pruwait/Nice_BusT4/img/3hs.jpg

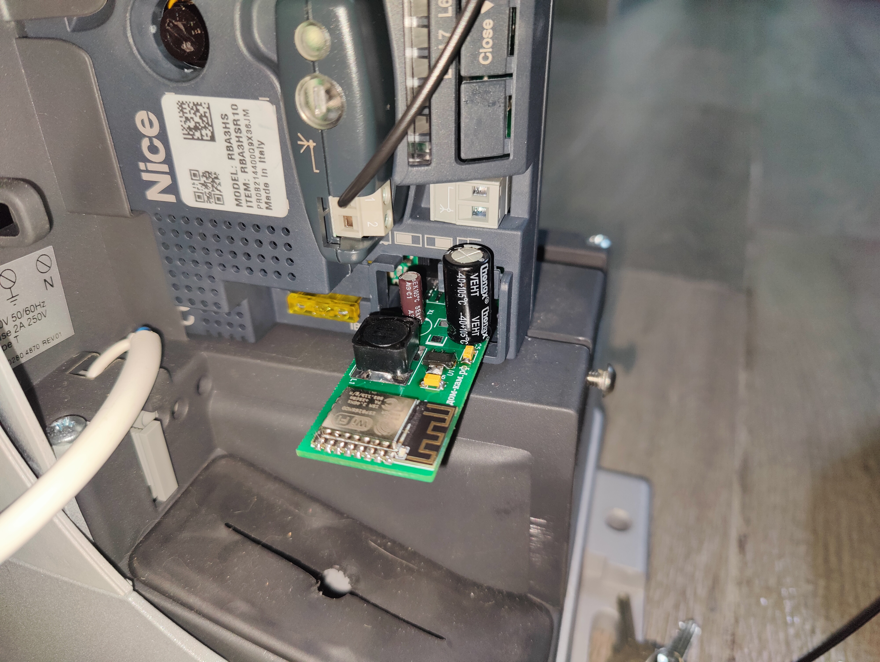
img/3hs.jpg
