pruwait/Nice_BusT4/img/924.jpg

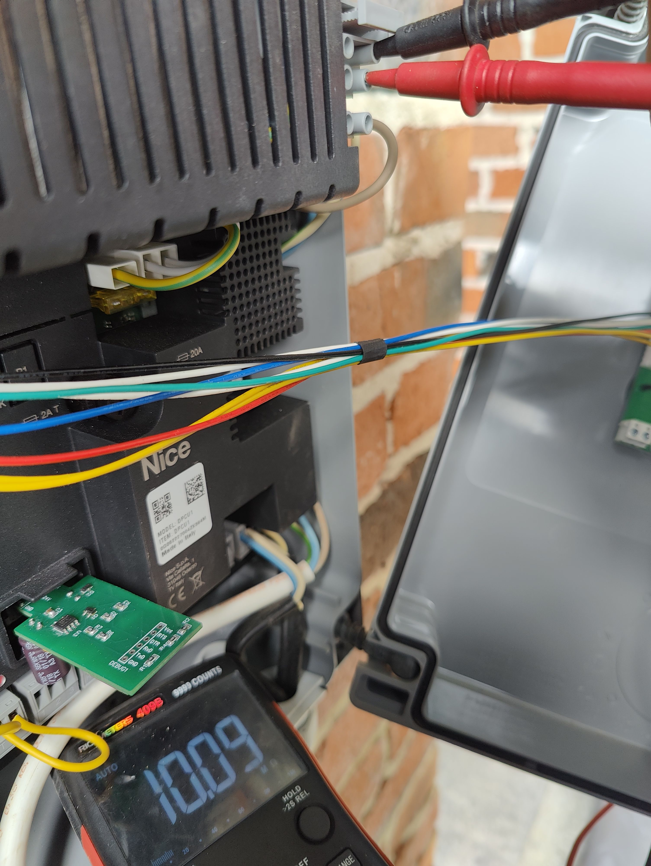
img/924.jpg
