pruwait/Nice_BusT4/img/IMG20240531091711.jpg

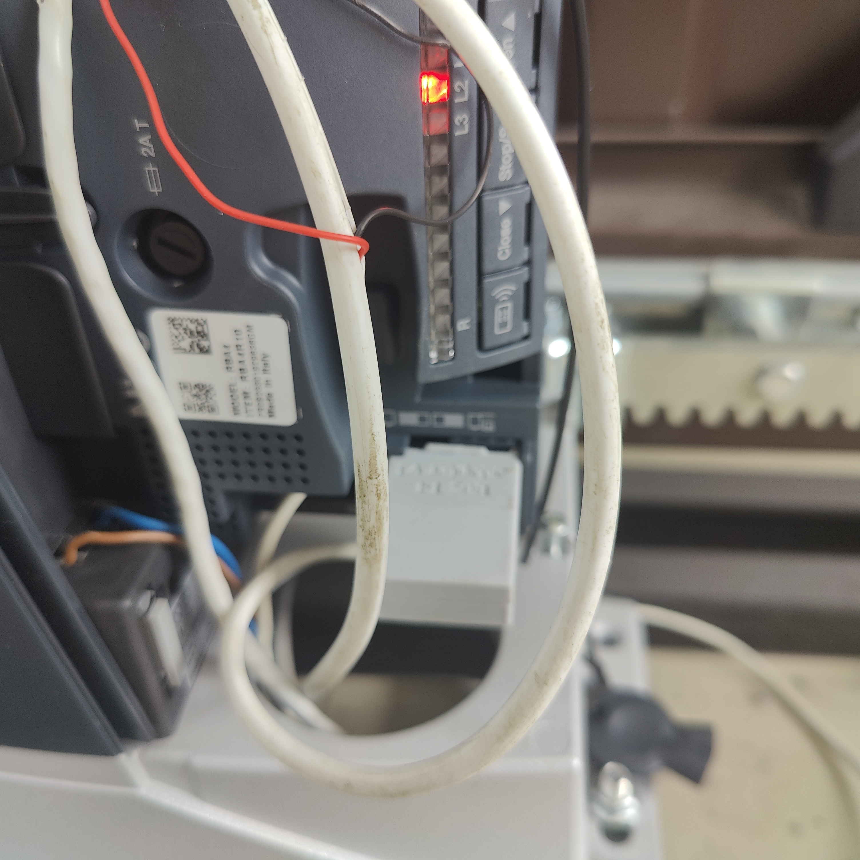
img/IMG20240531091711.jpg
