pruwait/Nice_BusT4/img/IMG_20220113_160221.jpg

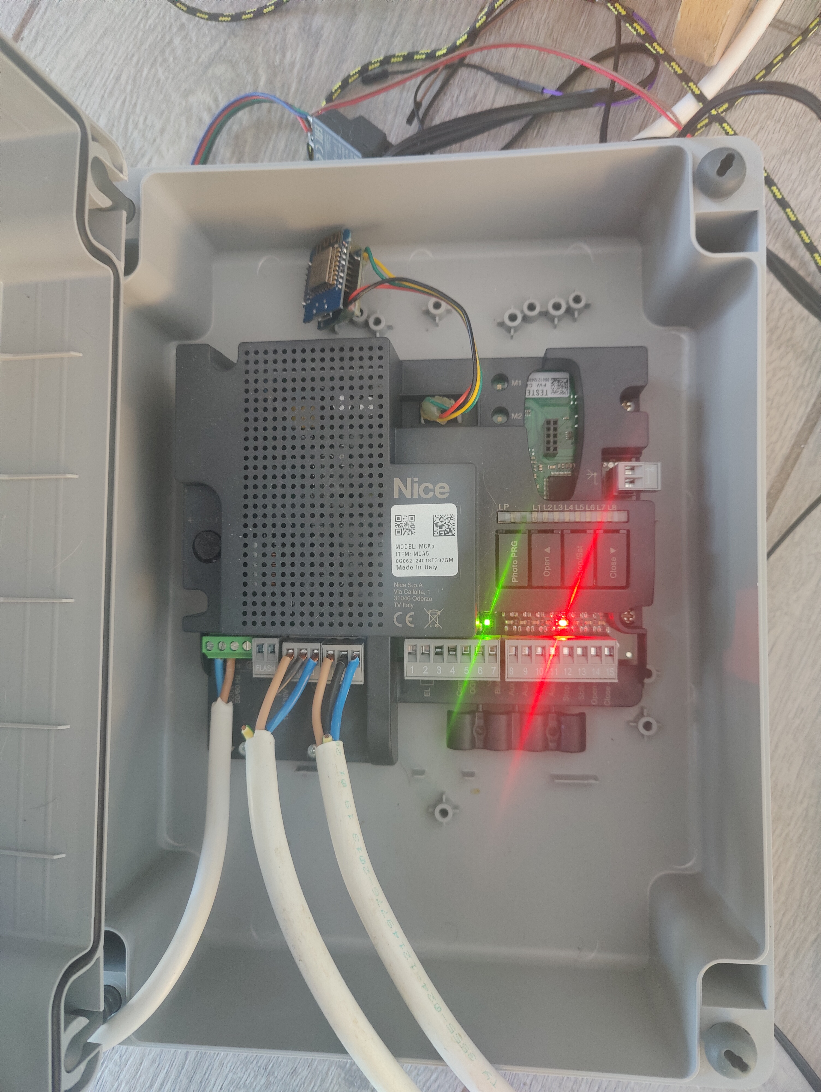
img/IMG_20220113_160221.jpg
