pruwait/Nice_BusT4/img/level-shifter.png

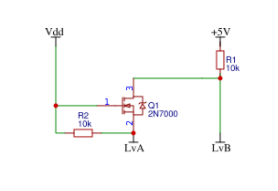
img/level-shifter.png
