pruwait/Nice_BusT4/img/mc824h.jpg

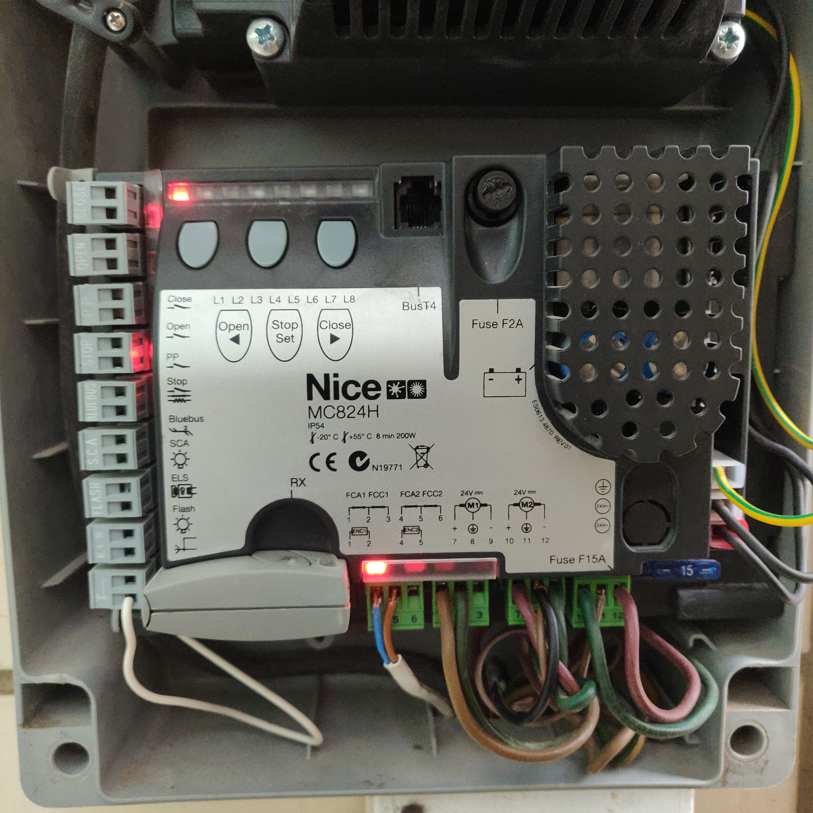
img/mc824h.jpg
