pruwait/Nice_BusT4/img/rba3c.jpg

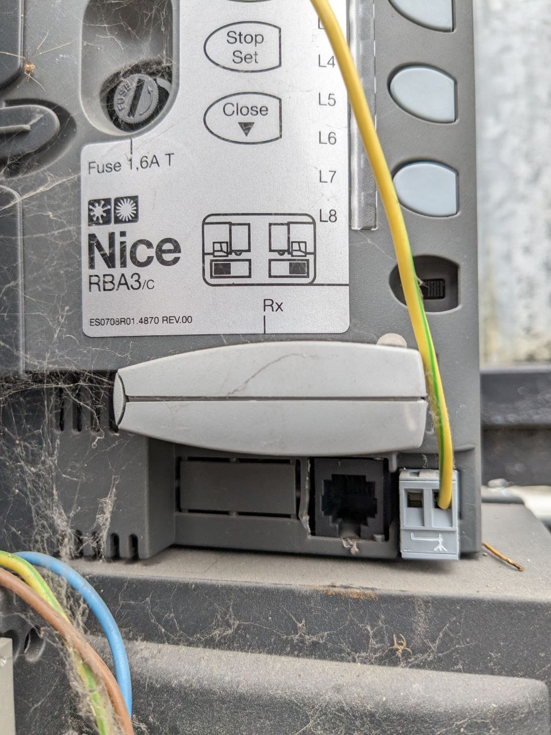
img/rba3c.jpg
