pruwait/Nice_BusT4/img/rba4.jpg

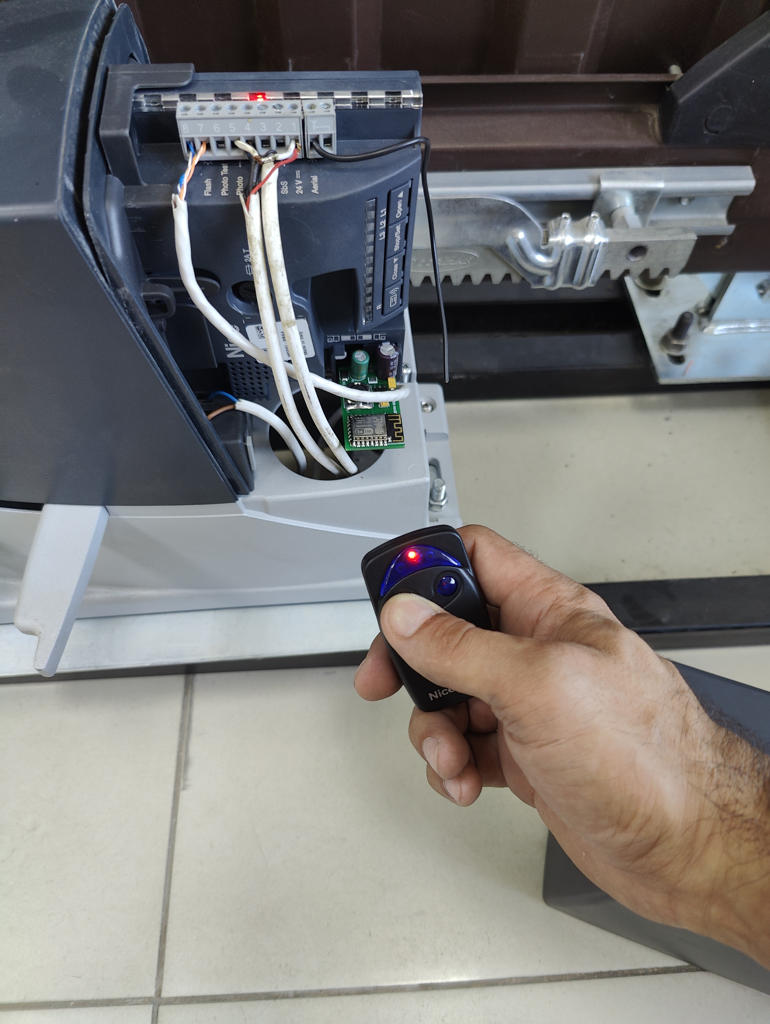
img/rba4.jpg
