pruwait/Nice_BusT4/img/spin.jpg

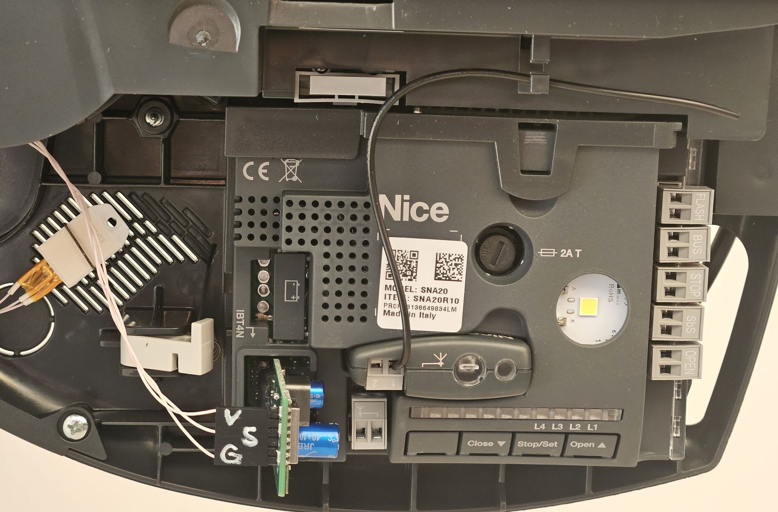
img/spin.jpg
