pruwait/Nice_BusT4/img/walky.jpg

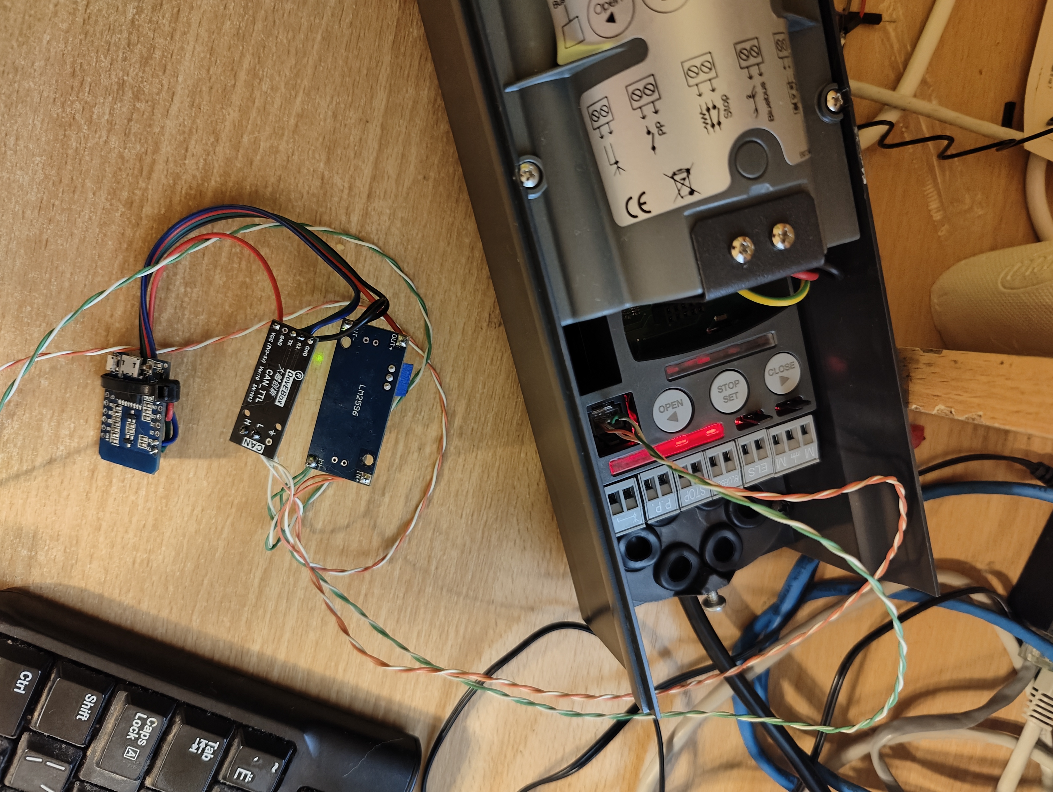
img/walky.jpg
