pruwait/Nice_BusT4/img/WeMos_DC_Power_Shield_Schematic_v1.1.jpg

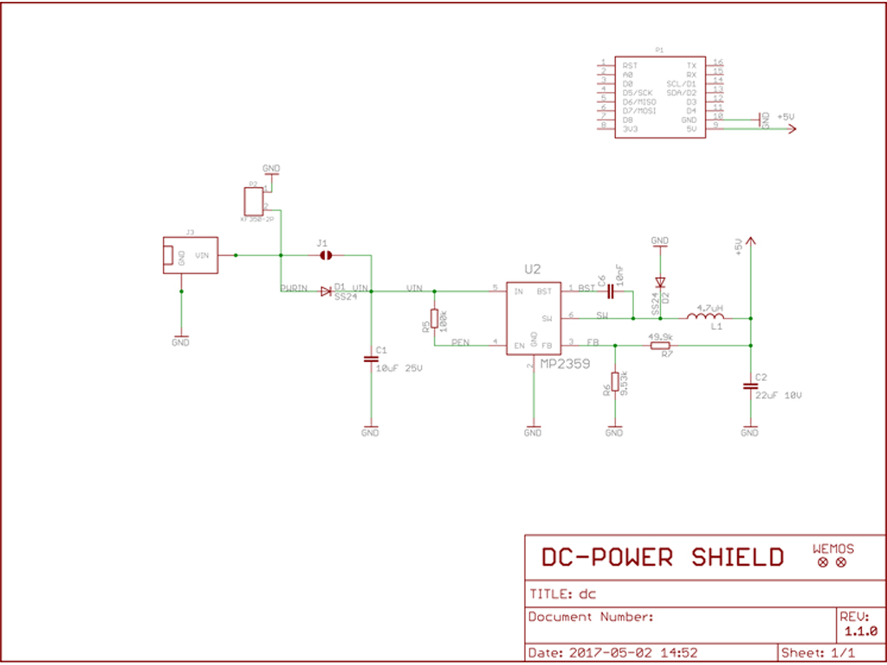
img/WeMos_DC_Power_Shield_Schematic_v1.1.jpg
