pruwait/Nice_BusT4/(threads)

Thread 1 (2022-10-21):

схемy сделать  доступной нa easyeda.com

Egyras, 2022-10-21:
Здравствуй, может ты сможешь схемy сделать  доступной нa easyeda.com ? Вставь ссылку в README.md.

ashumkin, 2022-12-13:
плюсую

pruwait, 2023-03-12:
Схема выложена как картинка. Срисовать ее в easyeda сможет каждый за полчаса, там всего 2 микросборки и немного обвязки. Моя схема задействована в крупном проекте, который я не буду выкладывать.

Closed 2023-03-12.

Thread 2 (2022-10-29):

Update Command

gregoricz, 2022-10-29:
Hi, thanks for your great work with this integration. Everything works perfect, bud when I open gate with RF remote (nice), don't get to home assistant actual gate state (open or close). Could you help me with update command for update button?

Thanks,
Regards, Gregori

pruwait, 2023-03-12:
Print your esp log here

Closed 2023-04-08.

Thread 4 (2023-03-13):

Vsb is not always 24V

xdanik, 2023-03-13:
As the title says - Vsb (power provided from the Nice motor) is not always 24V DC.

I have a Nice Road 400 with RBA4R10 control unit and I have measured 34V between the Vsb and GND pins.
This would certainly kill the Wemos D1 power shield as its rated for 24V max.
I was lucky to measure it before connecting it 😉.

When you look at the [schematics for IBT4N](https://github.com/pruwait/Nice_BusT4/blob/078a50ae64e9510a1a09f8f559e44e69ae7ddb0c/Nice%20IBT4N.pdf) there is a U1 - 78L05 linear voltage regulator powered by the Vsb line that is rated for up to 35V.

It would be great to mention this in the readme.

pruwait, 2023-03-16:
Yep. Its Nice joke. 24V is 34V for all devices.
My Wemos D1 power shield is working good with 34V. But it was a prototip.
Device 2.0 has power unit with XL1509 with wide 4.5V to 40V Input Voltage Range.

Closed 2023-03-16.

Thread 6 (2023-06-25):

Nice SPIN

podly, 2023-06-25:
Hi!

First of all thank you for great job you did!

I made a copy of this device and connected it to my garage door Nice SPIN. I can open and close gate, I can also send command for partial open and this is working fine. However there is no feedback on gate position other then fully close or fully open. If I send Partial Open 1 command, gates open partially, but ESP reports state closed and position 0. Setting position is also not working - only partial open commands works.

Second what I noticed is lack of stop button in Home Assistant entity - it shows only up and down arrow:

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

Info from ESP:
<code>
[22:01:24][C][bus_t4.cover:502]:   Bus T4 Cover
[22:01:24][C][bus_t4.cover:509]:   Type: Sectional door
[22:01:24][C][bus_t4.cover:524]:   Maximum encoder or timer position: 0
[22:01:24][C][bus_t4.cover:525]:   Opened gate position: 2048
[22:01:24][C][bus_t4.cover:526]:   Closed gate position: 0
[22:01:24][C][bus_t4.cover:529]:   Manufacturer: NICE
[22:01:24][C][bus_t4.cover:532]:   Drive unit: SPINBUSR10
[22:01:24][C][bus_t4.cover:535]:   Drive hardware: 598BR00
[22:01:24][C][bus_t4.cover:538]:   Drive firmware: BZ01
[22:01:24][C][bus_t4.cover:541]:   Drive description: NewSpin
[22:01:24][C][bus_t4.cover:544]:   Gateway address: 0x0066
[22:01:24][C][bus_t4.cover:545]:   Drive address: 0x0003
[22:01:24][C][bus_t4.cover:546]:   Receiver address: 0x0000
[22:01:24][C][bus_t4.cover:549]:   Receiver:
[22:01:24][C][bus_t4.cover:552]:   Receiver hardware:
[22:01:24][C][bus_t4.cover:555]:   Receiver firmware:
[22:01:24][C][bus_t4.cover:558]:   Receiver description:
[22:01:24][C][bus_t4.cover:560]:   Auto close - L1: No
[22:01:24][C][bus_t4.cover:561]:   Close after photo - L2: No
[22:01:24][C][bus_t4.cover:562]:   Always close - L3: No
[22:01:24][C][captive_portal:088]: Captive Portal:
[22:01:24][C][web_server:151]: Web Server:
[22:01:24][C][web_server:152]:   Address: nice-bust4-uart.local:80
[22:01:24][C][mdns:108]: mDNS:
[22:01:24][C][mdns:109]:   Hostname: nice-bust4-uart

</code>

I also see also in ESP logs that sometimes checksum errors are reported:

<code>
[20:26:35][D][button:010]: 'Step by step' Pressed.
[20:26:35][I][bus_t4.cover:660]: Sent: 55.0C.00.03.00.66.01.05.61.01.82.01.64.E6.0C (15)
[20:26:35][I][bus_t4.cover:157]: Package received: 55.0E.FF.FF.00.03.01.07.05.04.02.84.19.00.00.9B.0E (17)
[20:26:35][D][bus_t4.cover:366]: RSP package received
[20:26:35][I][bus_t4.cover:369]: HEX data 19.00
[20:26:35][I][bus_t4.cover:372]: Drive controller package
[20:26:35][I][bus_t4.cover:376]: RUN submenu
[20:26:35][I][bus_t4.cover:391]: Command: CLOSE
[20:26:35][I][bus_t4.cover:437]: Operation: 84
[20:26:35][D][cover:170]: 'Nice SPIN' - Publishing:
[20:26:35][D][cover:173]:   Position: 0%
[20:26:35][D][cover:186]:   Current Operation: CLOSING
[20:26:37][W][bus_t4.cover:126]: Received invalid message checksum 1 01!=58
[20:26:46][I][bus_t4.cover:157]: Package received: 55.0E.FF.FF.00.03.01.07.05.04.02.05.19.00.00.1A.0E (17)

</code>

and sometimes operations ends with timeout:

<code>
[20:38:48][D][button:010]: 'Step by step' Pressed.
[20:38:48][I][bus_t4.cover:660]: Sent: 55.0C.00.03.00.66.01.05.61.01.82.01.64.E6.0C (15)
[20:38:49][I][bus_t4.cover:157]: Package received: 55.0E.FF.FF.00.03.01.07.05.04.02.86.19.00.00.99.0E (17)
[20:38:49][D][bus_t4.cover:366]: RSP package received
[20:38:49][I][bus_t4.cover:369]: HEX data 19.00
[20:38:49][I][bus_t4.cover:372]: Drive controller package
[20:38:49][I][bus_t4.cover:376]: RUN submenu
[20:38:49][I][bus_t4.cover:402]: Operation completed with timeout
[20:38:49][I][bus_t4.cover:437]: Operation: 86
[20:38:56][D][button:010]: 'Step by step' Pressed.

</code>

any chance that you can help me with this?

br,

Michal

feeleep75, 2023-11-25:
@podly - maybe you can share an EasyEDA project or full BOM at least?

pruwait, 2024-01-22:
Not all gate drives send their position during the maneuver. The spin is not sent in your logs.
When turned on for the first time, initialization occurs and the drive receives command 11.
It responds with its position.
Can you send command 11 and show the log?

Closed 2024-02-10.

Thread 7 (2023-08-07):

RJ11 connector

ekozan, 2023-08-07:
Hi,

Just a small confirmation before burn every thing

I got an unit with an RJ11 port,

I read you say it's an +24v(34v reality lol ) GND CAN+ CAN-

I plan to use an  an TXS0108E  for isolate the thing do you think it's can work  ?

pruwait, 2024-01-22:
Должен сработать, по уровням сигнала подходит

Closed 2024-01-22.

Thread 8 (2023-08-16):

Hardware needed

rici44, 2023-08-16:
Hi there. I would like to ask what type of hardware exactly do I need to setup Nice_BusT4? I understand that I need Wemos D1 mini with Power shield but do not know what else. Thank you.

ekozan, 2023-09-02:
Check the schematic you
Need to solder or find some look like card

pruwait, 2024-01-22:
> Hi there. Do you have EasyEda project published? I would like to order this adapter.

Gerber files from easyeda is present in my project

Closed 2024-01-22.

Thread 13 (2024-07-07):

Am I doing something wrong

darkcamo12, 2024-07-07:
Hey
Using this wiring diagram  (https://github.com/xdanik/Nice_BusT4/blob/main/img/diagram.jpg) But have been unable to get it working with the nice filo 400 sliding gate

I’m using the example yaml and not sure if I need to change anything in

Any help would be appreciated

pruwait, 2024-07-28:
let me see your log

darkcamo12, 2024-07-30:
So what I think might be the issue is my controller is different??

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

since I was getting no response back from the controller

Thread 14 (2024-07-17):

Support for ESP32-type boards

karol27, 2024-07-17:
I need it working with cable, not wireless. I have WT32-ETH01 based on ESP32.
During compilation there is error with UART0.
Please add support for ESP32 type boards.

pruwait, 2024-07-28:
https://github.com/pruwait/Nice_BusT4/tree/esp32_beta

Closed 2024-07-28.

Thread 16 (2024-09-24):

Nice Soon - need assistance

englolo, 2024-09-24:
Hi,
I'd be grateful for anyone assistance.
I have model Nice Soon SO2000 with RJ11 4p4c connector.
I discovered by measuring the GND and VCC (33v) pin, but I still don't know which is the rx and tx pin.
I label them by color from phone cable.
Can I use a level shifter or does it have to be a can bus.

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

englolo, 2024-12-05:
Problem solved.
Used SN65HVD230 CAN board with d1 mini. More testing is needed, but it works initially.

Closed 2024-12-05.

Thread 17 (2024-10-21):

Тесты по протоколу обмена данными.

mega1974, 2024-10-21:
Уважаемые коллеги!

Я собрал прототип устройства использовав код pruwait с двумя скоростями uart.
Устройство заработало с приводом Nice RD400.
Анализ пакетов логическим анализатором показал, что первый пакет с переменным битрейтом практически по длительности такой же как и если передавать первый байт 0x00 перед 0x55 с постоянным битрейтом 19200.
Переписав код:

const char master_tx_buf_sbs[] = {0x00, 0x55, 0x0c, 0x00, 0x03, 0x00, 0x81, 0x01, 0x05, 0x86, 0x01, 0x82, 0x01, 0x64, 0xe6, 0x0c}; //команда "SBS"
    const char master_tx_buf_stop[] = {0x00, 0x55, 0x0c, 0x00, 0x03, 0x00, 0x81, 0x01, 0x05, 0x86, 0x01, 0x82, 0x02, 0x64, 0xe5, 0x0c}; //команда "Stop"
    const char master_tx_buf_open[] = {0x00, 0x55, 0x0c, 0x00, 0x03, 0x05, 0x81, 0x01, 0x05, 0x83, 0x01, 0x82, 0x03, 0x64, 0xe4, 0x0c}; //команда "Open"
    const char master_tx_buf_close[] = {0x00, 0x55, 0x0c, 0x00, 0x03, 0x05, 0x81, 0x01, 0x05, 0x83, 0x01, 0x82, 0x04, 0x64, 0xe3, 0x0c}; //команда "Close"

...

void send_command (const char _master_tx_buf[]) {
// UART set_baudrate Break
// Работает хорошо с wemos d1 mini и Arduino Core 3.0.2
// Отправка break + посылка
 uart_flush(_uart);                                                                                           // очищаем uart
 //uart_set_baudrate(_uart, baud_break);                                                         // занижаем бодрэйт
 //uart_write(_uart, (char *)break_tx_buf, sizeof(break_tx_buf));                       // отправляем ноль на низкой скорости, длиинный ноль
 //uart_wait_tx_empty(_uart);                                                                           // ждём, пока отправка завершится. Здесь в библиотеке uart.h (esp8266 core 3.0.2) ошибка, ожидания недостаточно при дальнейшем uart_set_baudrate().
 //delayMicroseconds(90);                                                                              // добавляем ожидания, иначе скорость переключится раньше отправки. С задержкой на d1-mini я получил идеальный сигнал, break = 520us? отправлял 0x00
 uart_set_baudrate(_uart, baud_work);                                                        // возвращаем рабочий бодрэйт
 uart_write(_uart, (char *)_master_tx_buf, sizeof(master_tx_buf_open));     // отправляем основную посылку
 uart_wait_tx_empty(_uart);                                                                        // ждем завершения отправки
}

Данный код заработал без проблем.

Thread 18 (2024-12-29):

Troubleshooting communication with MC824H

beestree, 2024-12-29:
Hi, I'm having trouble getting this to work with my MC824H.

My setup is as follows: I have an ESP8266 with a Waveshare CAN transceiver connected to the TX/RX pins and the 3V3 and GND pins of the ESP. I've connected the CANH and CANL directly to the MC824H with an RJ11 connector.

I got this working, but now I can't get it to connect. The logs show that I get the exact messages I send reflected back.
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

My question is: Is this the correct way to set this up? Do I need a resistor to prevent reflections? And if so, why did this work previously?

xCapeITA, 2025-06-03:
Hi @beestree have you got the right commands for mc824h?
I am seeking them but cannot find.
Plus I don't have any feedback from unit (but I can send commands). Do you connect it with resistor? Thanks

Thread 20 (2025-05-25):

No response to WHO from RBA3R10

sanjay900, 2025-05-25:
Just got a brand new RB400, with a RBA3R10 control board

When sending out the WHO command, i see responses from the OXI receiver but never any from the drive controller
Any idea what could cause that?

If i open and close the gate with a remote, i do get events with the current state of the gate, i just can't seem to send any commands to make the gate open or close from home assistant.

I am using an ESP32, so i am using a fork https://github.com/sanjay900/Nice_BusT4 since it was easier to get that working.

Here are some logs from the esp32
[logs_gate_run(2).txt](https://github.com/user-attachments/files/20430030/logs_gate_run.2.txt)

sanjay900, 2025-05-25:
i suspect this is my fault actually and its something wrong with my fork.

sanjay900, 2025-05-25:
Yep, turned out all i had to do was swap to ESP-IDF, the setting of the baud rate was taking too long with the arduino framework.

Closed 2025-05-25.

Thread 24 (2025-09-30):

No drive detected ?

fdriver33, 2025-09-30:
Hi,
Great work on this, thx. But I have a problem with my Walky1024. I see communication on BUS, but any command via esphome is not executed.
I think, maybe problem with no drive info in log, no walky drive recognition .... What I do wrong  ?

`21:38:43.049][C][template.switch:087]: Template Switch 'Auto-closing'
[21:38:43.049][C][template.switch:087]:   Restore Mode: disabled
[21:38:43.054][C][template.switch:057]:   Optimistic: NO
[21:38:43.055][C][bus_t4.cover:737]:   Bus T4 Cover
[21:38:43.055][C][bus_t4.cover:756]:   Type: Unknown gate, 0x55
[21:38:43.055][C][bus_t4.cover:759]:   Max encoder or timer position: 0
[21:38:43.055][C][bus_t4.cover:760]:   Open gate position: 2048
[21:38:43.055][C][bus_t4.cover:761]:   Closed gate position: 0
[21:38:43.055][C][bus_t4.cover:764]:   Manufacturer: UU
[21:38:43.055][C][bus_t4.cover:767]:   Drive:
[21:38:43.055][C][bus_t4.cover:770]:   Drive hardware:
[21:38:43.056][C][bus_t4.cover:773]:   Drive firmware:
[21:38:43.056][C][bus_t4.cover:776]:   Drive description:
[21:38:43.056][C][bus_t4.cover:778]:   Gateway address: 0x0066
[21:38:43.056][C][bus_t4.cover:779]:   Drive address: 0x0000
[21:38:43.056][C][bus_t4.cover:780]:   Receiver address: 0x000A
[21:38:43.056][C][bus_t4.cover:783]:   Receiver: OXIBD group
[21:38:43.057][C][bus_t4.cover:786]:   Receiver hardware: 672B
[21:38:43.057][C][bus_t4.cover:789]:   Receiver firmware: BK00H
[21:38:43.057][C][bus_t4.cover:792]:   Receiver description: Radio
[21:38:43.057][C][bus_t4.cover:794]:   Auto-closing - L1: No
[21:38:43.057][C][bus_t4.cover:795]:   Close after photo - L2: No
[21:38:43.057][C][bus_t4.cover:796]:   Always close - L3: No
[21:38:43.061][C][captive_portal:122]: Captive Portal:
[21:38:43.070][C][web_server:309]: Web Server:
[21:38:43.070][C][web_server:309]:   Address: nice-wifi.local:80
[21:38:43.082][C][esphome.ota:075]: Over-The-Air updates:
[21:38:43.082][C][esphome.ota:075]:   Address: nice-wifi.local:8266
[21:38:43.082][C][esphome.ota:075]:   Version: 2
[21:38:43.085][C][safe_mode:018]: Safe Mode:
[21:38:43.085][C][safe_mode:018]:   Successful after: 60s
[21:38:43.085][C][safe_mode:018]:   Invoke after: 10 attempts
[21:38:43.085][C][safe_mode:018]:   Duration: 300s
[21:38:43.100][C][web_server.ota:235]: Web Server OTA
[21:38:43.103][C][api:205]: Server:
[21:38:43.103][C][api:205]:   Address: nice-wifi.local:6053
[21:38:43.104][C][api:215]:   Noise encryption: NO
[21:38:43.117][C][mdns:213]: mDNS:
[21:38:43.117][C][mdns:213]:   Hostname: nice-wifi
[21:38:48.314][I][bus_t4.cover:904]: Sent: 55.0D.00.FF.00.66.08.06.97.00.04.99.00.00.9D.0D (16)
[21:38:48.370][I][bus_t4.cover:208]: Packet received: 55.0E.00.66.00.0A.08.07.63.00.04.19.01.00.0A.16.0E (17)
[21:38:48.375][I][bus_t4.cover:228]: Data string:
[21:38:48.375][I][bus_t4.cover:228]:
[21:38:48.375][I][bus_t4.cover:230]: HEX data 0A
[21:38:48.476][I][bus_t4.cover:904]: Sent: 55.0D.00.FF.00.66.08.06.97.00.09.99.00.00.90.0D (16)
[21:38:48.478][I][bus_t4.cover:208]: Packet received: 55.0D.00.FF.00.66.08.06.97.00.09.99.00.00.90.0D (16)
[21:38:48.494][I][bus_t4.cover:208]: Packet received: 55.18.00.66.00.0A.08.11.75.00.09.19.0B.00.4F.58.49.42.44.20.67.72.6F.75.70.1C.18 (27)
[21:38:48.497][I][bus_t4.cover:228]: Data string: OXIBD group
[21:38:48.497][I][bus_t4.cover:230]: HEX data 4F.58.49.42.44.20.67.72.6F.75.70 (11)
[21:38:48.497][C][bus_t4.cover:399]:   Receiver: OXIBD group
[21:38:48.604][I][bus_t4.cover:904]: Sent: 55.0D.00.0A.00.66.08.06.62.00.09.99.00.00.90.0D (16)
[21:38:48.610][I][bus_t4.cover:208]: Packet received: 55.0D.00.0A.00.66.08.06.62.00.09.99.00.00.90.0D (16)
[21:38:48.627][I][bus_t4.cover:208]: Packet received: 55.18.00.66.00.0A.08.11.75.00.09.19.0B.00.4F.58.49.42.44.20.67.72.6F.75.70.1C.18 (27)
[21:38:48.630][I][bus_t4.cover:228]: Data string: OXIBD group
[21:38:48.630][I][bus_t4.cover:230]: HEX data 4F.58.49.42.44.20.67.72.6F.75.70 (11)
[21:38:48.630][C][bus_t4.cover:399]:   Receiver: OXIBD group
[21:38:48.736][I][bus_t4.cover:904]: Sent: 55.0D.00.0A.00.66.08.06.62.00.0A.99.00.00.93.0D (16)
[21:38:48.739][I][bus_t4.cover:208]: Packet received: 55.0D.00.0A.00.66.08.06.62.00.0A.99.00.00.93.0D (16)
[21:38:48.757][I][bus_t4.cover:208]: Packet received: 55.11.00.66.00.0A.08.0A.6E.00.0A.19.04.00.36.37.32.42.66.11 (20)
[21:38:48.780][I][bus_t4.cover:228]: Data string: 672B
[21:38:48.780][I][bus_t4.cover:230]: HEX data 36.37.32.42
[21:38:48.880][I][bus_t4.cover:904]: Sent: 55.0D.00.0A.00.66.08.06.62.00.0B.99.00.00.92.0D (16)
[21:38:48.885][I][bus_t4.cover:208]: Packet received: 55.0D.00.0A.00.66.08.06.62.00.0B.99.00.00.92.0D (16)
[21:38:48.885][I][bus_t4.cover:208]: Packet received: 55.12.00.66.00.0A.08.0B.6F.00.0B.19.05.00.42.4B.30.30.48.56.12 (21)
[21:38:48.885][I][bus_t4.cover:228]: Data string: BK00H
[21:38:48.885][I][bus_t4.cover:230]: HEX data 42.4B.30.30.48 (5)
[21:38:49.009][I][bus_t4.cover:904]: Sent: 55.0D.00.0A.00.66.08.06.62.00.0C.99.00.00.95.0D (16)
[21:38:49.013][I][bus_t4.cover:208]: Packet received: 55.0D.00.0A.00.66.08.06.62.00.0C.99.00.00.95.0D (16)
[21:38:49.045][I][bus_t4.cover:208]: Packet received: 55.12.00.66.00.0A.08.0B.6F.00.0C.19.05.00.52.61.64.69.6F.41.12 (21)
[21:38:49.049][I][bus_t4.cover:228]: Data string: Radio
[21:38:49.049][I][bus_t4.cover:230]: HEX data 52.61.64.69.6F (5)
[21:38:58.317][I][bus_t4.cover:904]: Sent: 55.0D.00.FF.00.66.08.06.97.00.04.99.00.00.9D.0D (16)
[21:38:58.322][I][bus_t4.cover:208]: Packet received: 55.0D.00.FF.00.66.08.06.97.00.04.99.00.00.9D.0D (16)
[21:38:58.334][I][bus_t4.cover:208]: Packet received: 55.0E.00.66.00.0A.08.07.63.00.04.19.01.00.0A.16.0E (17)
[21:38:58.337][I][bus_t4.cover:228]: Data string:
[21:38:58.337][I][bus_t4.cover:228]:
[21:38:58.337][I][bus_t4.cover:230]: HEX data 0A
[21:38:58.445][I][bus_t4.cover:904]: Sent: 55.0D.00.FF.00.66.08.06.97.00.09.99.00.00.90.0D (16)
[21:38:58.450][I][bus_t4.cover:208]: Packet received: 55.0D.00.FF.00.66.08.06.97.00.09.99.00.00.90.0D (16)
[21:38:58.464][I][bus_t4.cover:208]: Packet received: 55.18.00.66.00.0A.08.11.75.00.09.19.0B.00.4F.58.49.42.44.20.67.72.6F.75.70.1C.18 (27)
[21:38:58.467][I][bus_t4.cover:228]: Data string: OXIBD group
[21:38:58.467][I][bus_t4.cover:230]: HEX data 4F.58.49.42.44.20.67.72.6F.75.70 (11)
[21:38:58.467][C][bus_t4.cover:399]:   Receiver: OXIBD group
[21:38:58.574][I][bus_t4.cover:904]: Sent: 55.0D.00.0A.00.66.08.06.62.00.09.99.00.00.90.0D (16)
[21:38:58.611][I][bus_t4.cover:208]: Packet received: 55.18.00.66.00.0A.08.11.75.00.09.19.0B.00.4F.58.49.42.44.20.67.72.6F.75.70.1C.18 (27)
[21:38:58.614][I][bus_t4.cover:228]: Data string: OXIBD group
[21:38:58.614][I][bus_t4.cover:230]: HEX data 4F.58.49.42.44.20.67.72.6F.75.70 (11)
[21:38:58.614][C][bus_t4.cover:399]:   Receiver: OXIBD group
[21:38:58.723][I][bus_t4.cover:904]: Sent: 55.0D.00.0A.00.66.08.06.62.00.0A.99.00.00.93.0D (16)
[21:38:58.728][I][bus_t4.cover:208]: Packet received: 55.0D.00.0A.00.66.08.06.62.00.0A.99.00.00.93.0D (16)
[21:38:58.758][I][bus_t4.cover:208]: Packet received: 55.11.00.66.00.0A.08.0A.6E.00.0A.19.04.00.36.37.32.42.66.11 (20)
[21:38:58.762][I][bus_t4.cover:228]: Data string: 672B
[21:38:58.762][I][bus_t4.cover:230]: HEX data 36.37.32.42
[21:38:58.868][I][bus_t4.cover:904]: Sent: 55.0D.00.0A.00.66.08.06.62.00.0B.99.00.00.92.0D (16)
[21:38:58.873][I][bus_t4.cover:208]: Packet received: 55.0D.00.0A.00.66.08.06.62.00.0B.99.00.00.92.0D (16)
[21:38:58.910][I][bus_t4.cover:208]: Packet received: 55.12.00.66.00.0A.08.0B.6F.00.0B.19.05.00.42.4B.30.30.48.56.12 (21)
[21:38:58.915][I][bus_t4.cover:228]: Data string: BK00H
[21:38:58.915][I][bus_t4.cover:230]: HEX data 42.4B.30.30.48 (5)
[21:38:59.017][I][bus_t4.cover:904]: Sent: 55.0D.00.0A.00.66.08.06.62.00.0C.99.00.00.95.0D (16)
[21:38:59.022][W][bus_t4.cover:190]: Received invalid message checksum 2 95!=D5
[21:38:59.034][I][bus_t4.cover:208]: Packet received: 55.12.00.66.00.0A.08.0B.6F.00.0C.19.05.00.52.61.64.69.6F.41.12 (21)
[21:38:59.039][I][bus_t4.cover:228]: Data string: Radio
[21:38:59.039][I][bus_t4.cover:230]: HEX data 52.61.64.69.6F (5)
[21:39:08.328][I][bus_t4.cover:904]: Sent: 55.0D.00.FF.00.66.08.06.97.00.04.99.00.00.9D.0D (16)
[21:39:08.334][I][bus_t4.cover:208]: Packet received: 55.0D.00.FF.00.66.08.06.97.00.04.99.00.00.9D.0D (16)
[21:39:08.334][I][bus_t4.cover:904]: Sent: 55.0D.00.FF.00.66.08.06.97.00.09.99.00.00.90.0D (16)
[21:39:18.356][I][bus_t4.cover:904]: Sent: 55.0D.00.FF.00.66.08.06.97.00.04.99.00.00.9D.0D (16)
[21:39:18.358][I][bus_t4.cover:208]: Packet received: 55.0D.00.FF.00.66.08.06.97.00.04.99.00.00.9D.0D (16)
[21:39:18.367][I][bus_t4.cover:208]: Packet received: 55.0E.00.66.00.0A.08.07.63.00.04.19.01.00.0A.16.0E (17)
[21:39:18.371][I][bus_t4.cover:228]: Data string:
[21:39:18.371][I][bus_t4.cover:228]:
[18:12:58.095][I][bus_t4.cover:178]: HEX data
[18:12:58.103][I][bus_t4.cover:161]: Package received: 55.12.00.66.00.0A.08.0B.6F.00.0C.19.05.00.52.61.64.69.6F.41.12 (21)
[18:12:58.103][D][bus_t4.cover:175]: An EVT data packet has been received. Data size 5
[18:12:58.103][I][bus_t4.cover:178]: HEX data 52.61.64.69.6F (5)
[18:13:06.025][D][button:023]: 'Step-by-step' Pressed.
[18:13:06.028][I][bus_t4.cover:664]: Sent: 55.0C.00.00.00.66.01.05.62.01.82.01.64.E6.0C (15)
[18:13:06.033][I][bus_t4.cover:161]: Package received: 55.0C.00.00.00.66.01.05.62.01.82.01.64.E6.0C (15)
[18:13:07.519][I][bus_t4.cover:664]: Sent: 55.0D.00.FF.00.66.08.06.97.00.04.99.00.00.9D.0D (16)
[18:13:07.522][I][bus_t4.cover:161]: Package received: 55.0D.00.FF.00.66.08.06.97.00.04.99.00.00.9D.0D (16)
[18:13:07.522][D][bus_t4.cover:175]: An EVT data packet has been received. Data size 0
[18:13:07.522][I][bus_t4.cover:178]: HEX data
[18:13:07.537][I][bus_t4.cover:161]: Package received: 55.0E.00.66.00.0A.08.07.63.00.04.19.01.00.0A.16.0E (17)
[18:13:07.540][D][bus_t4.cover:175]: An EVT data packet has been received. Data size 1
[18:13:07.540][I][bus_t4.cover:178]: HEX data 0A

`
