pruwait/Nice_BusT4/(commit log)

2022-01-01 Команда STOP от OVIEW 0x0081 приводу 0x0003
2022-01-01 Отправка UART Break
2022-01-05 Бета версия.
    Работает отправка команд через API Hassio
2022-01-05 Add files via upload
    Бета версия
2022-01-13 Add files via upload
    Первая рабочая версия.
    Работает:
    - Команды "Открыть", "Стоп", "Закрыть"
    - Статусы "Открывается", "Закрывается", "Открыто", "Закрыто"
    - Отправка RAW команд.
2022-04-02 Update nice-bust4.cpp
    Добавлено считывание статусов привода и получение информации о контроллере
2022-04-02 Update nice-bust4.h
    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
2022-04-13 Update nice-bust4.cpp
    Добавлена обработка событий от концевика откатных ворот
2022-04-20 Добавлено получение максимального открытия в ROBUS
2022-04-20 Получение максимального открытия в ROBUS
2023-09-22 STOP кнопка в UI
2024-01-22 C iswalnum не собирается, ругается что такой функции нет (ESPHome 2023.12.8) Непонятно, откуда здесь юникод берется.
2024-01-23 Добавил SPIN в протестированные приводы с фото
2024-01-23 Добавил замечание, что напряжение на BusT4 может быть больше 24В.
2024-01-24 Nice Spin. Если ворота движутся и нажать кнопку стоп (на пульте или в приложении), то ворота останавливаются, но их статус в приложении остается прежним. По логам контроллер присылает ENDTIME. Учитыв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
    `[18:55:23][I][bus_t4.cover:221]: Получен пакет: 55.0E.FF.FF.00.03.01.07.05.04.02.02.65.00.00.61.0E (17)
    [18:55:23][D][bus_t4.cover:479]: Получен пакет RSP
    [18:55:23][I][bus_t4.cover:482]: Строка с данными: e
    [18:55:23][I][bus_t4.cover:484]: Данные HEX 65.00
    [18:55:23][I][bus_t4.cover:487]: П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
2024-01-24 Заменил isalnum/iswalnum на более подходящую функцию isxdigit
2024-01-26 Рефакторинг блока разбора подменю RUN пакета контроллера привода Обработка операции завешения частичного открывания
2024-01-26 Рефакторинг переменных для хранения адресов
2024-01-26 Вынос запроса текущего положения привода в отдельную функцию
2024-01-26 Вынос изменения текущего положения в отдельную функцию Добавлен порог для текущего положения, ниже которого ворота считаются полностью закрытыми
2024-01-30 Если привод сам не присылает свое текущее положение при движении - запрашиваем его. Интервал опроса задается через POSITION_UPDATE_INTERVAL.
2024-01-30 Отправлям запрос на текущее положение привода при любой остановке в промежуточном положении.
2024-01-31 Поддержка установки произвольного положения привода через отслеживание его положения и остановки в нужный момент (за счет задержек положение устанавливается с некоторой ошибкой) Исправлена ошибка с н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
    [nice-bust4.cpp, nice-bust4.h]
2024-01-31 Публикуем состояние только при изменении (backport baf7d3c xdanik/Nice_BusT4)
2024-01-31 Патчи для Road 400 (backport 59d1b94 xdanik/Nice_BusT4)
2024-02-01 Уменьшение интервала обновления положения привода по умолчанию
2024-04-21 Update nice-bust4.cpp
    Повторяем команды при незавершенном ответе от устройства
